BollhJon/ET20_Frackstock/IMG_20230823_181558.jpg

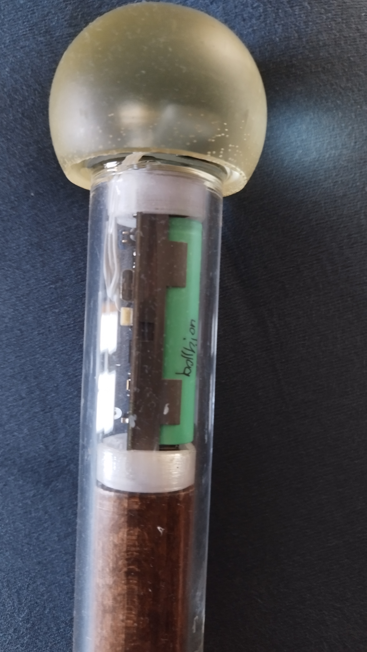
IMG_20230823_181558.jpg
