BollhJon/ET20_Frackstock/IMG_20230823_181706.jpg

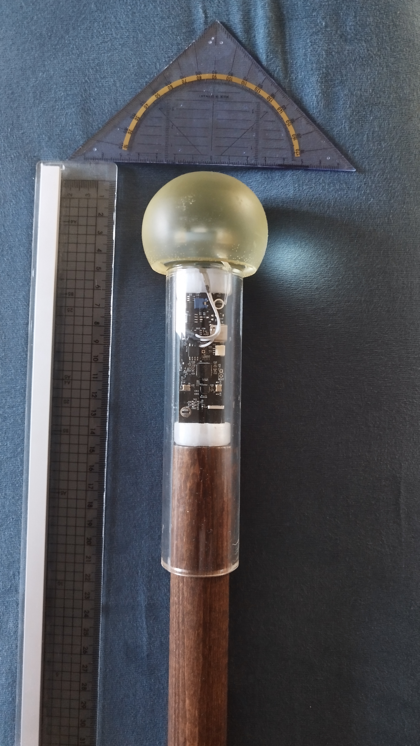
IMG_20230823_181706.jpg
