BollhJon/ET20_Frackstock/IMG_20230823_181511.jpg

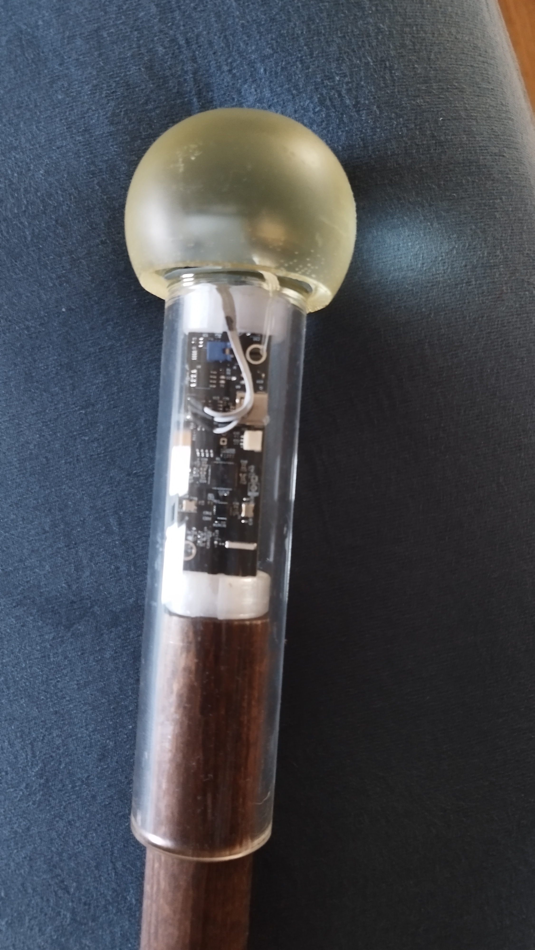
IMG_20230823_181511.jpg
