BollhJon/ET20_Frackstock/IMG_20230823_181516.jpg

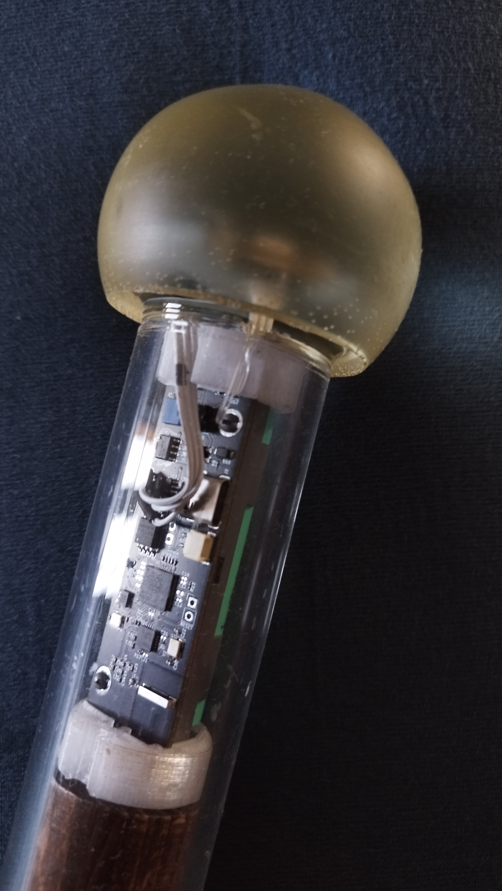
IMG_20230823_181516.jpg
