BollhJon/ET20_Frackstock/IMG_20230823_181718.jpg

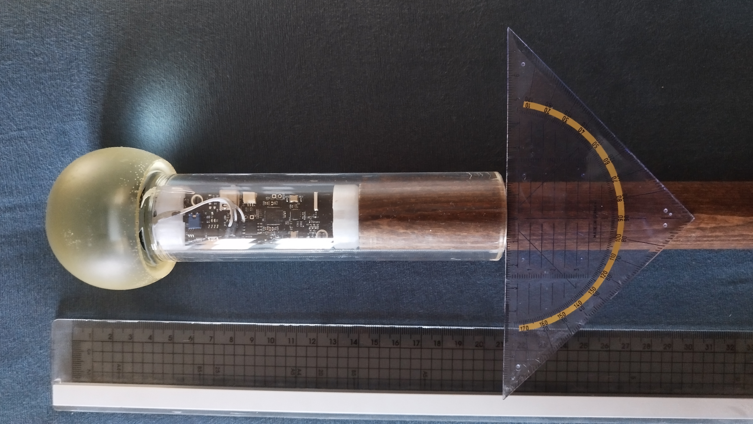
IMG_20230823_181718.jpg
