BollhJon/ET20_Frackstock/PCB_Frackstock/Frackstock.step

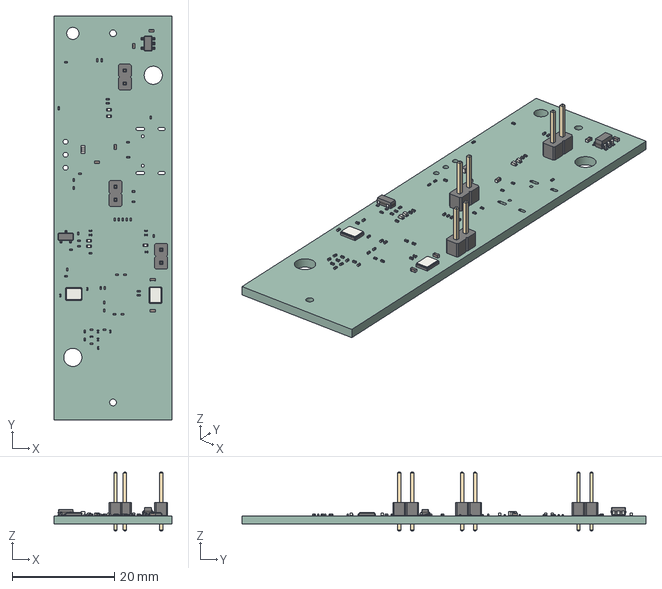
[picture p6: CAD file, 2023-08-23]
PCB_Frackstock/Frackstock.step
23.0 x 79.0 x 11.5 mm
Frackstock PCB
