BollhJon/ET20_Frackstock/PCB_Frackstock/Frackstock.kicad_pcb

## KiCad design PCB_Frackstock/Frackstock.kicad_pcb (2023-08-23)

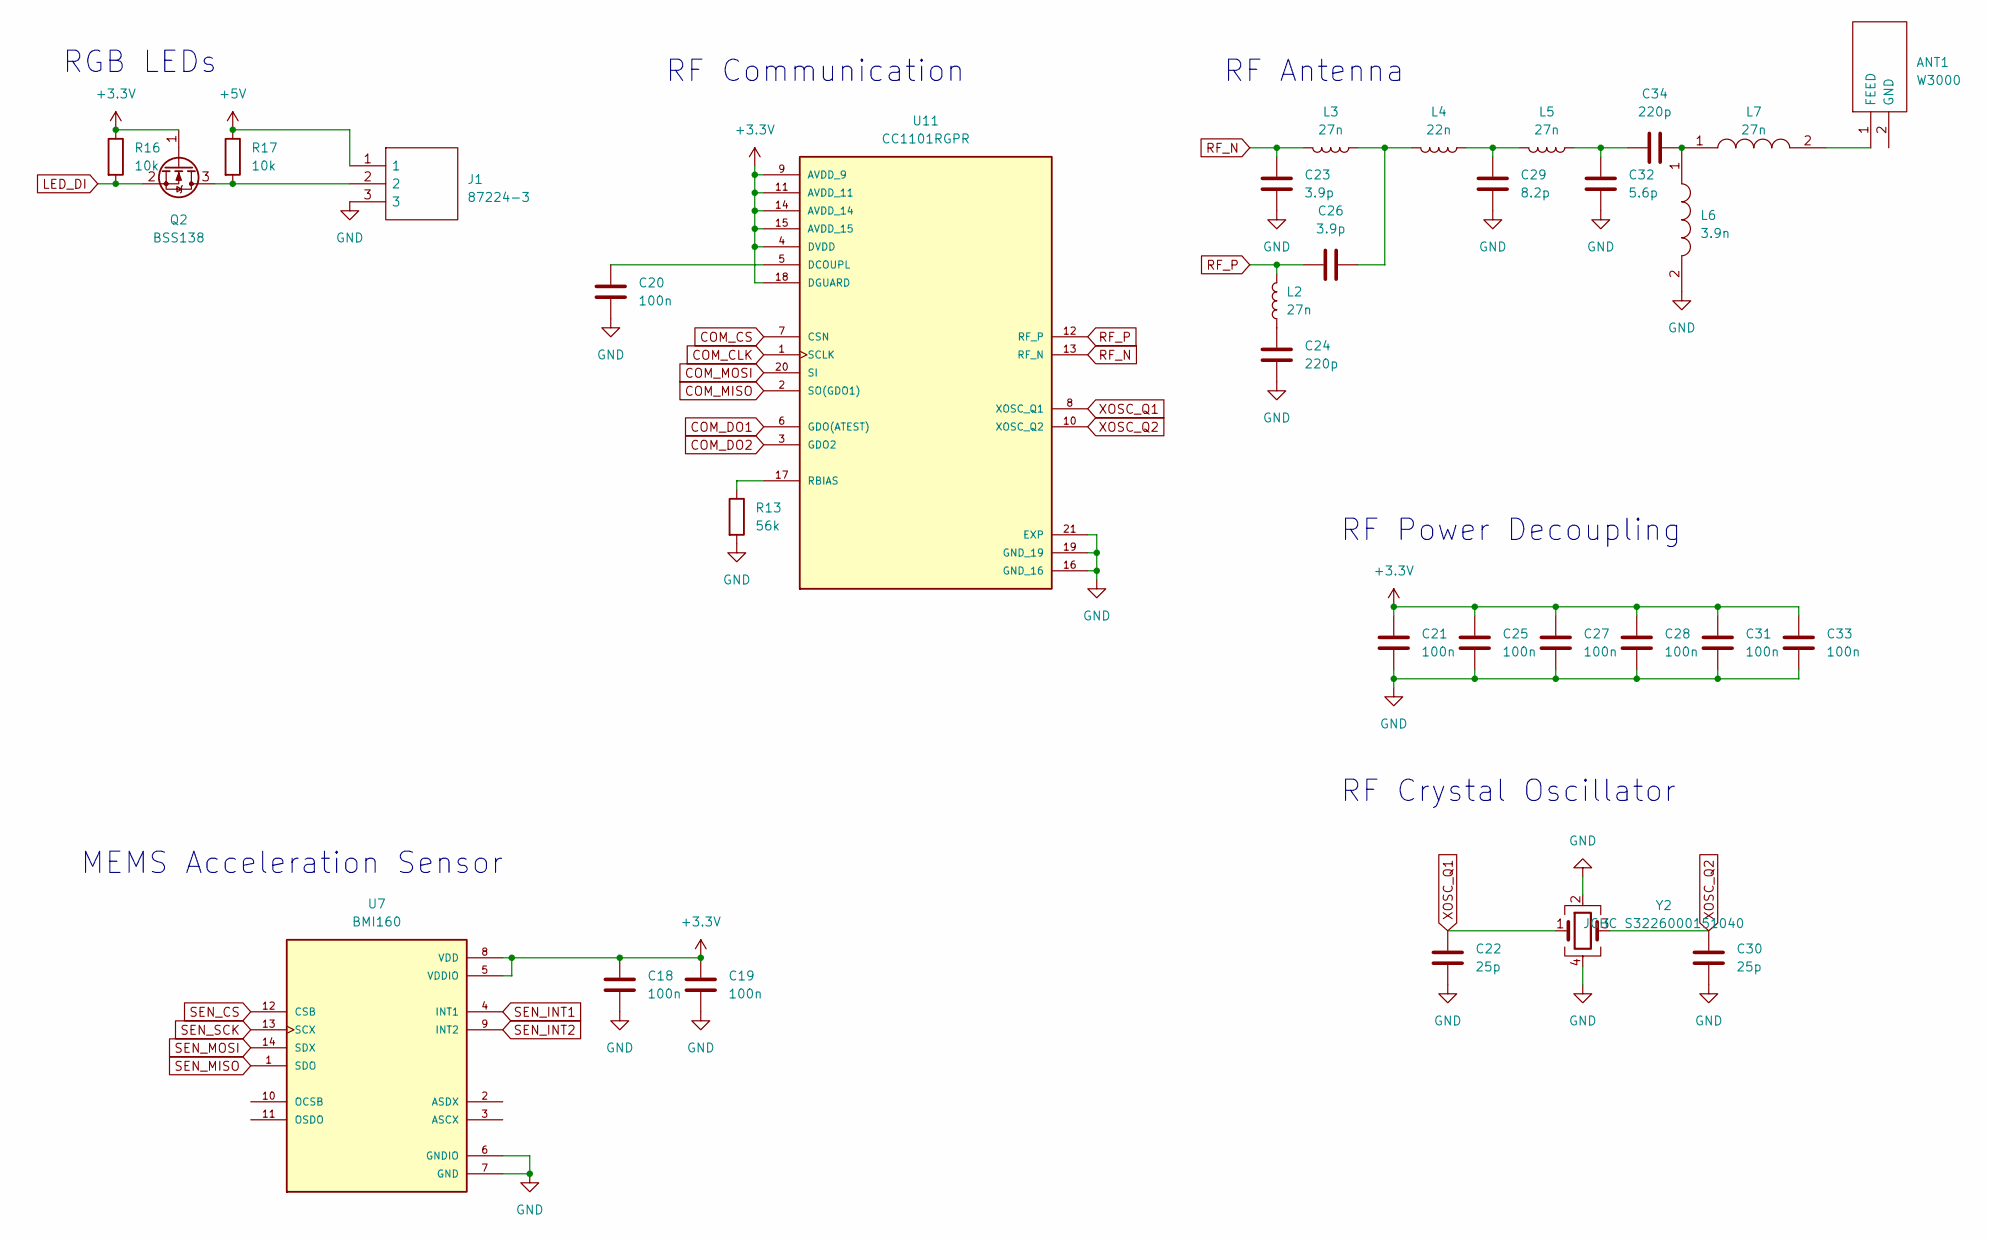
[picture p7: schematic InputOutput.kicad_sch]

Parts:
ANT1: W3000; Manufacturer_Part_Number W3000; Mouser Part Number 673-W3000
C18, C19, C20, C21, C25, C27, C28, C31, C33: 100n; C_0201_0603Metric; LCSC C66938
C22, C30: 25p; C_0402_1005Metric; LCSC C5186872
C23, C26: 3.9p; C_0201_0603Metric; LCSC C285000
C24, C34: 220p; C_0201_0603Metric; LCSC C258475
C29: 8.2p; C_0201_0603Metric; LCSC C469622
C32: 5.6p; C_0201_0603Metric; LCSC C285131
J1: 87224-3; 872243; Manufacturer_Part_Number 87224-3; Mouser Part Number 571-872243
L2, L3, L5: 27n; L_0201_0603Metric; LCSC C95928
L4: 22n; L_0201_0603Metric; LCSC C275177
L6: 3.9n; MHQ1005; Manufacturer_Part_Number MHQ1005P3N9CT000; Mouser Part Number 810-MHQ1005P3N9CT000
L7: 27n; MLG1005; Manufacturer_Part_Number MLG1005S27NHT000; Mouser Part Number 810-MLG1005S27NHT000
Q2: BSS138; SOT-23; LCSC C2938375
R13: 56k; R_0201_0603Metric; LCSC C851761
R16, R17: 10k; R_0201_0603Metric; LCSC C106225
U7: BMI160; PQFN50P250X300X88-14N; PARTREV 1.0; LCSC C94021
U11: CC1101RGPR; QFN50P400X400X100-21N; PARTREV 6-May-2020; LCSC C29953
Y2: JGHC S3226000151040; Crystal_SMD_3225-4Pin_3.2x2.5mm; LCSC C479205

Connections:
+3.3V: C18.1, C19.1, C21.1, C25.1, C27.1, C28.1, C31.1, C33.1, Q2.1 (G), R16.1, U7.5 (VDDIO), U7.8 (VDD), U11.4 (DVDD), U11.9 (AVDD_9), U11.11 (AVDD_11), U11.14 (AVDD_14), U11.15 (AVDD_15), U11.18 (DGUARD); also elsewhere on the board
+5V: J1.1, R17.1; also elsewhere on the board
COM_CLK: U11.1 (SCLK); also elsewhere on the board
COM_CS: U11.7 (CSN); also elsewhere on the board
COM_DO1: U11.6 (GDO(ATEST)); also elsewhere on the board
COM_DO2: U11.3 (GDO2); also elsewhere on the board
COM_MISO: U11.2 (SO(GDO1)); also elsewhere on the board
COM_MOSI: U11.20 (SI); also elsewhere on the board
GND: C18.2, C19.2, C20.2, C21.2, C22.2, C23.2, C24.2, C25.2, C27.2, C28.2, C29.2, C30.2, C31.2, C32.2, C33.2, J1.3, L6.2, R13.2, U7.6 (GNDIO), U7.7 (GND), U11.16 (GND_16), U11.19 (GND_19), U11.21 (EXP), Y2.2, Y2.4; also elsewhere on the board
LED_DI: Q2.2 (S), R16.2; also elsewhere on the board
unnamed: ANT1.1 (FEED), L7.2
unnamed: C24.1, L2.1
unnamed: C26.2, L3.1, L4.2
unnamed: C29.1, L4.1, L5.2
unnamed: C32.1, C34.1, L5.1
unnamed: C34.2, L6.1, L7.1
unnamed: J1.2, Q2.3 (D), R17.2
unnamed: C20.1, U11.5 (DCOUPL)
unnamed: R13.1, U11.17 (RBIAS)
RF_N: C23.1, L3.2, U11.13 (RF_N)
RF_P: C26.1, L2.2, U11.12 (RF_P)
SEN_CS: U7.12 (CSB); also elsewhere on the board
SEN_INT1: U7.4 (INT1); also elsewhere on the board
SEN_INT2: U7.9 (INT2); also elsewhere on the board
SEN_MISO: U7.1 (SDO); also elsewhere on the board
SEN_MOSI: U7.14 (SDX); also elsewhere on the board
SEN_SCK: U7.13 (SCX); also elsewhere on the board
XOSC_Q1: C22.1, U11.8 (XOSC_Q1), Y2.1
XOSC_Q2: C30.1, U11.10 (XOSC_Q2), Y2.3

Notes on the sheet:
MEMS Acceleration Sensor
RF Power Decoupling
RF Communication
RF Crystal Oscillator
RF Antenna
RGB LEDs

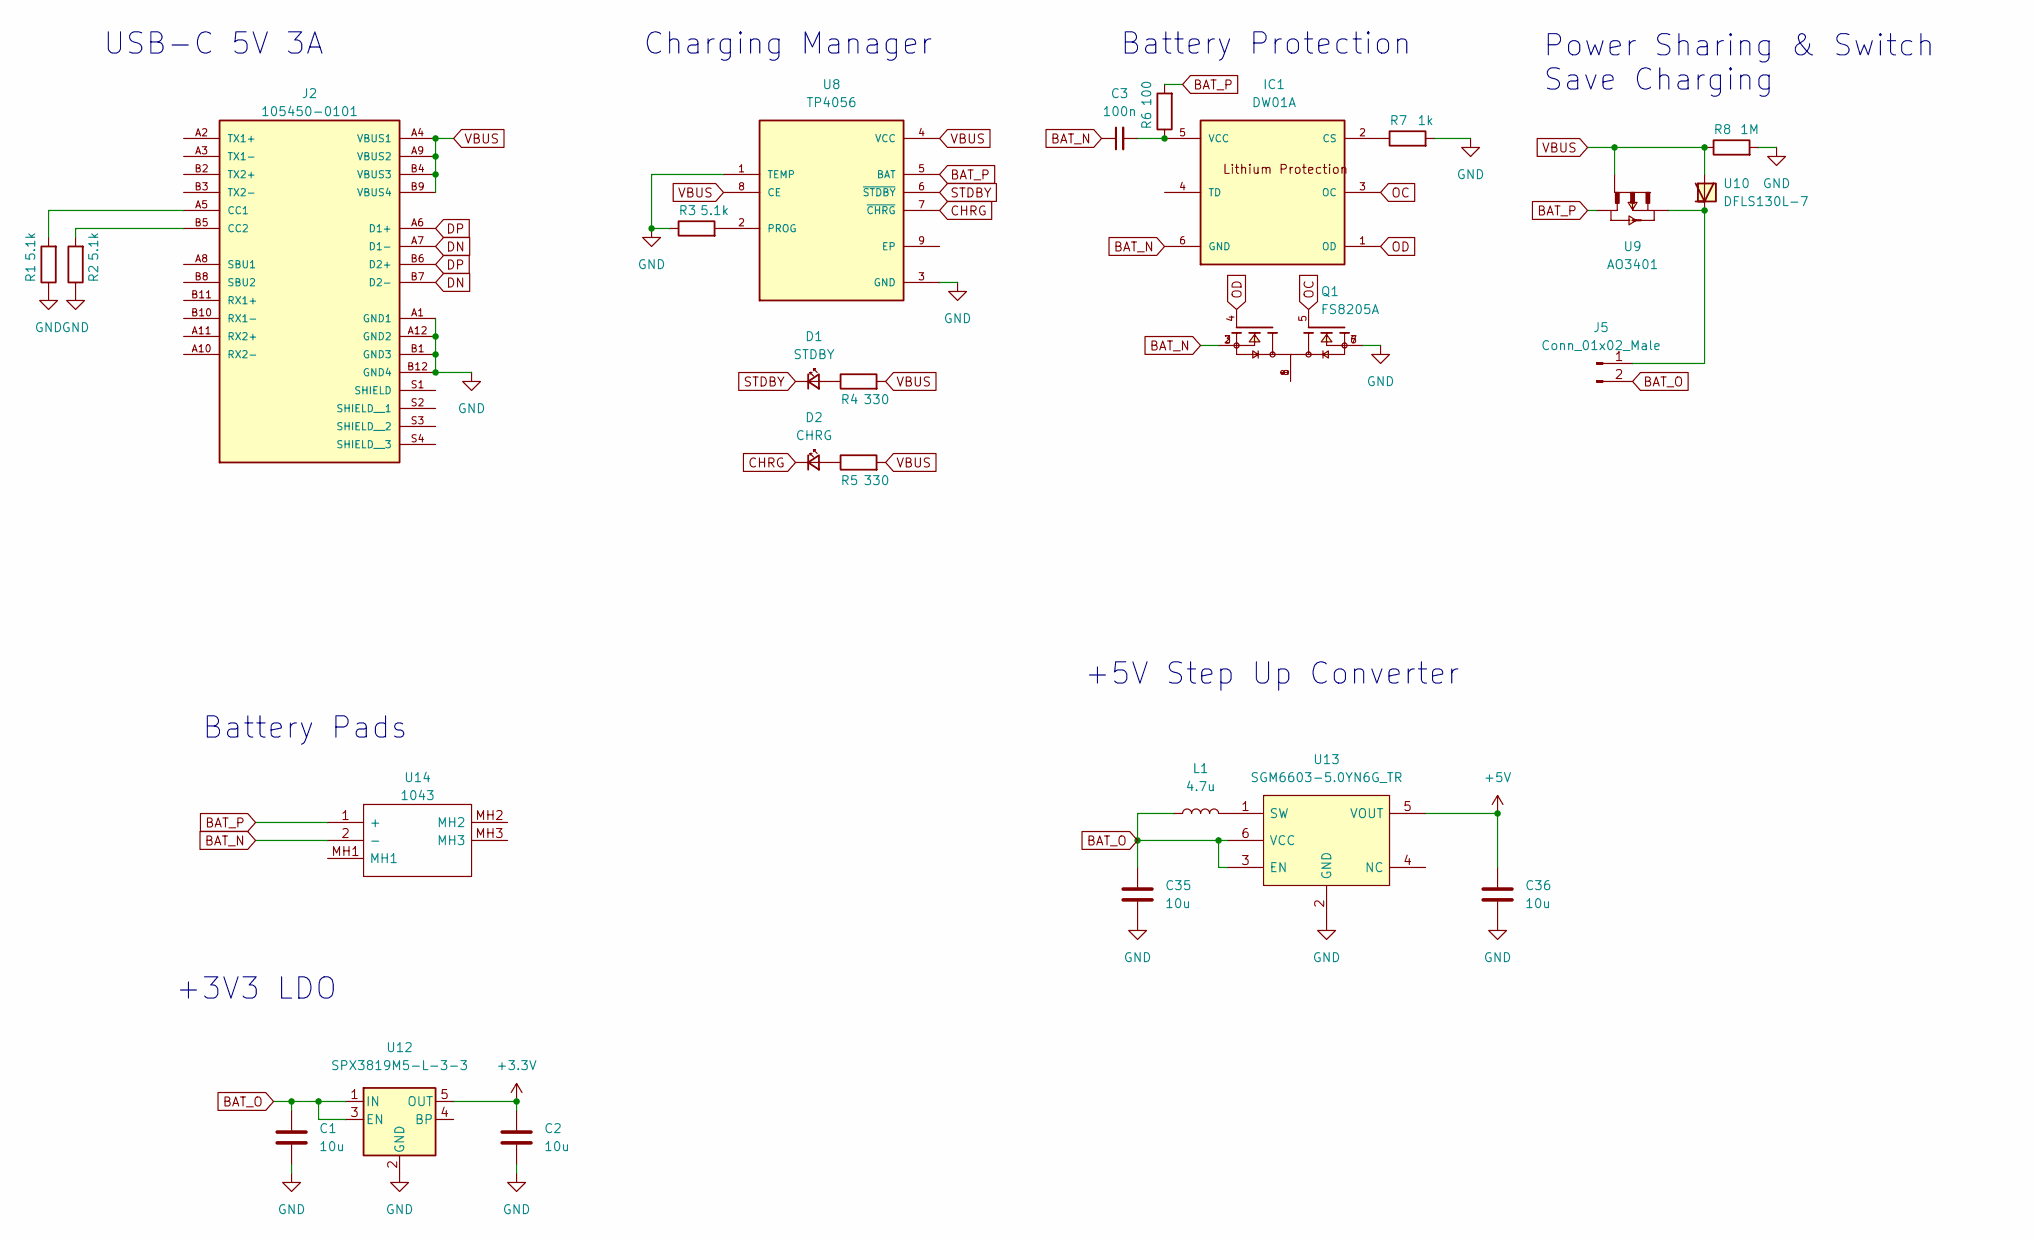
[picture p8: schematic PowerSupply.kicad_sch]

Parts:
C1, C2, C35, C36: 10u; C_0402_1005Metric; LCSC C15525
C3: 100n; C_0201_0603Metric; LCSC C66938
D1: STDBY; LED_0402_1005Metric; LCSC C434446
D2: CHRG; LED_0402_1005Metric; LCSC C434445
IC1: DW01A; SOT23-6; MPN DW01A; LCSC C351410
J2: 105450-0101; MOLEX_105450-0101; LCSC C134092
J5: Conn_01x02_Male; PinHeader_1x02_P2.54mm_Vertical
L1: 4.7u; L_0603_1608Metric; LCSC C1034
Q1: FS8205A; SOP65P640X120-8N; PARTREV 1.7; LCSC C16052
R1, R2, R3: 5.1k; R_0201_0603Metric; LCSC C274341
R4, R5: 330; R_0201_0603Metric; LCSC C851717
R6: 100; R_0201_0603Metric; LCSC C77623
R7: 1k; R_0201_0603Metric; LCSC C138165
R8: 1M; R_0201_0603Metric; LCSC C473482
U8: TP4056; SOP127P600X175-9N; LCSC C725790
U9: AO3401; SOT23; LCSC C727156
U10: DFLS130L-7; POWERDI123; LCSC C110493
U12: SPX3819M5-L-3-3; SOT-23-5; LCSC C9055
U13: SGM6603-5.0YN6G_TR; SOT23-6; Manufacturer_Part_Number SGM6603-5.0YN6G/TR; LCSC C79689
U14: 1043; Manufacturer_Part_Number 1043; Mouser Part Number 534-1043

Connections:
+3.3V: C2.1, U12.5 (OUT); also elsewhere on the board
+5V: C36.1, U13.5 (VOUT); also elsewhere on the board
BAT_N: C3.1, IC1.6 (GND), Q1.2, Q1.3, U14.2 (-)
BAT_O: C1.1, C35.1, J5.2, L1.1, U12.1 (IN), U12.3 (EN), U13.3 (EN), U13.6 (VCC)
BAT_P: R6.2, U8.5 (BAT), U9.3, U14.1 (+)
CHRG: D2.1 (K), U8.7 (~CHRG)
DN: J2.A7 (D1-), J2.B7 (D2-); also elsewhere on the board
DP: J2.A6 (D1+), J2.B6 (D2+); also elsewhere on the board
GND: C1.2, C2.2, C35.2, C36.2, J2.A1 (GND1), J2.A12 (GND2), J2.B1 (GND3), J2.B12 (GND4), Q1.6, Q1.7, R1.1, R2.1, R3.1, R7.2, R8.2, U8.1 (TEMP), U8.3 (GND), U12.2 (GND), U13.2 (GND); also elsewhere on the board
unnamed: D1.2 (A), R4.1
unnamed: D2.2 (A), R5.1
unnamed: IC1.2 (CS), R7.1
unnamed: C3.2, IC1.5 (VCC), R6.1
unnamed: J2.A5 (CC1), R1.2
unnamed: J2.B5 (CC2), R2.2
unnamed: J5.1, U9.2, U10.P$1
unnamed: Q1.1, Q1.8
unnamed: R3.2, U8.2 (PROG)
unnamed: L1.2, U13.1 (SW)
OC: IC1.3 (OC), Q1.5
OD: IC1.1 (OD), Q1.4
STDBY: D1.1 (K), U8.6 (~STDBY)
VBUS: J2.A4 (VBUS1), J2.A9 (VBUS2), J2.B4 (VBUS3), J2.B9 (VBUS4), R4.2, R5.2, R8.1, U8.4 (VCC), U8.8 (CE), U9.1, U10.P$2

Notes on the sheet:
Power Sharing & Switch Save Charging
+5V Step Up Converter
Battery Pads
+3V3 LDO
Battery Protection
Charging Manager
USB-C 5V 3A

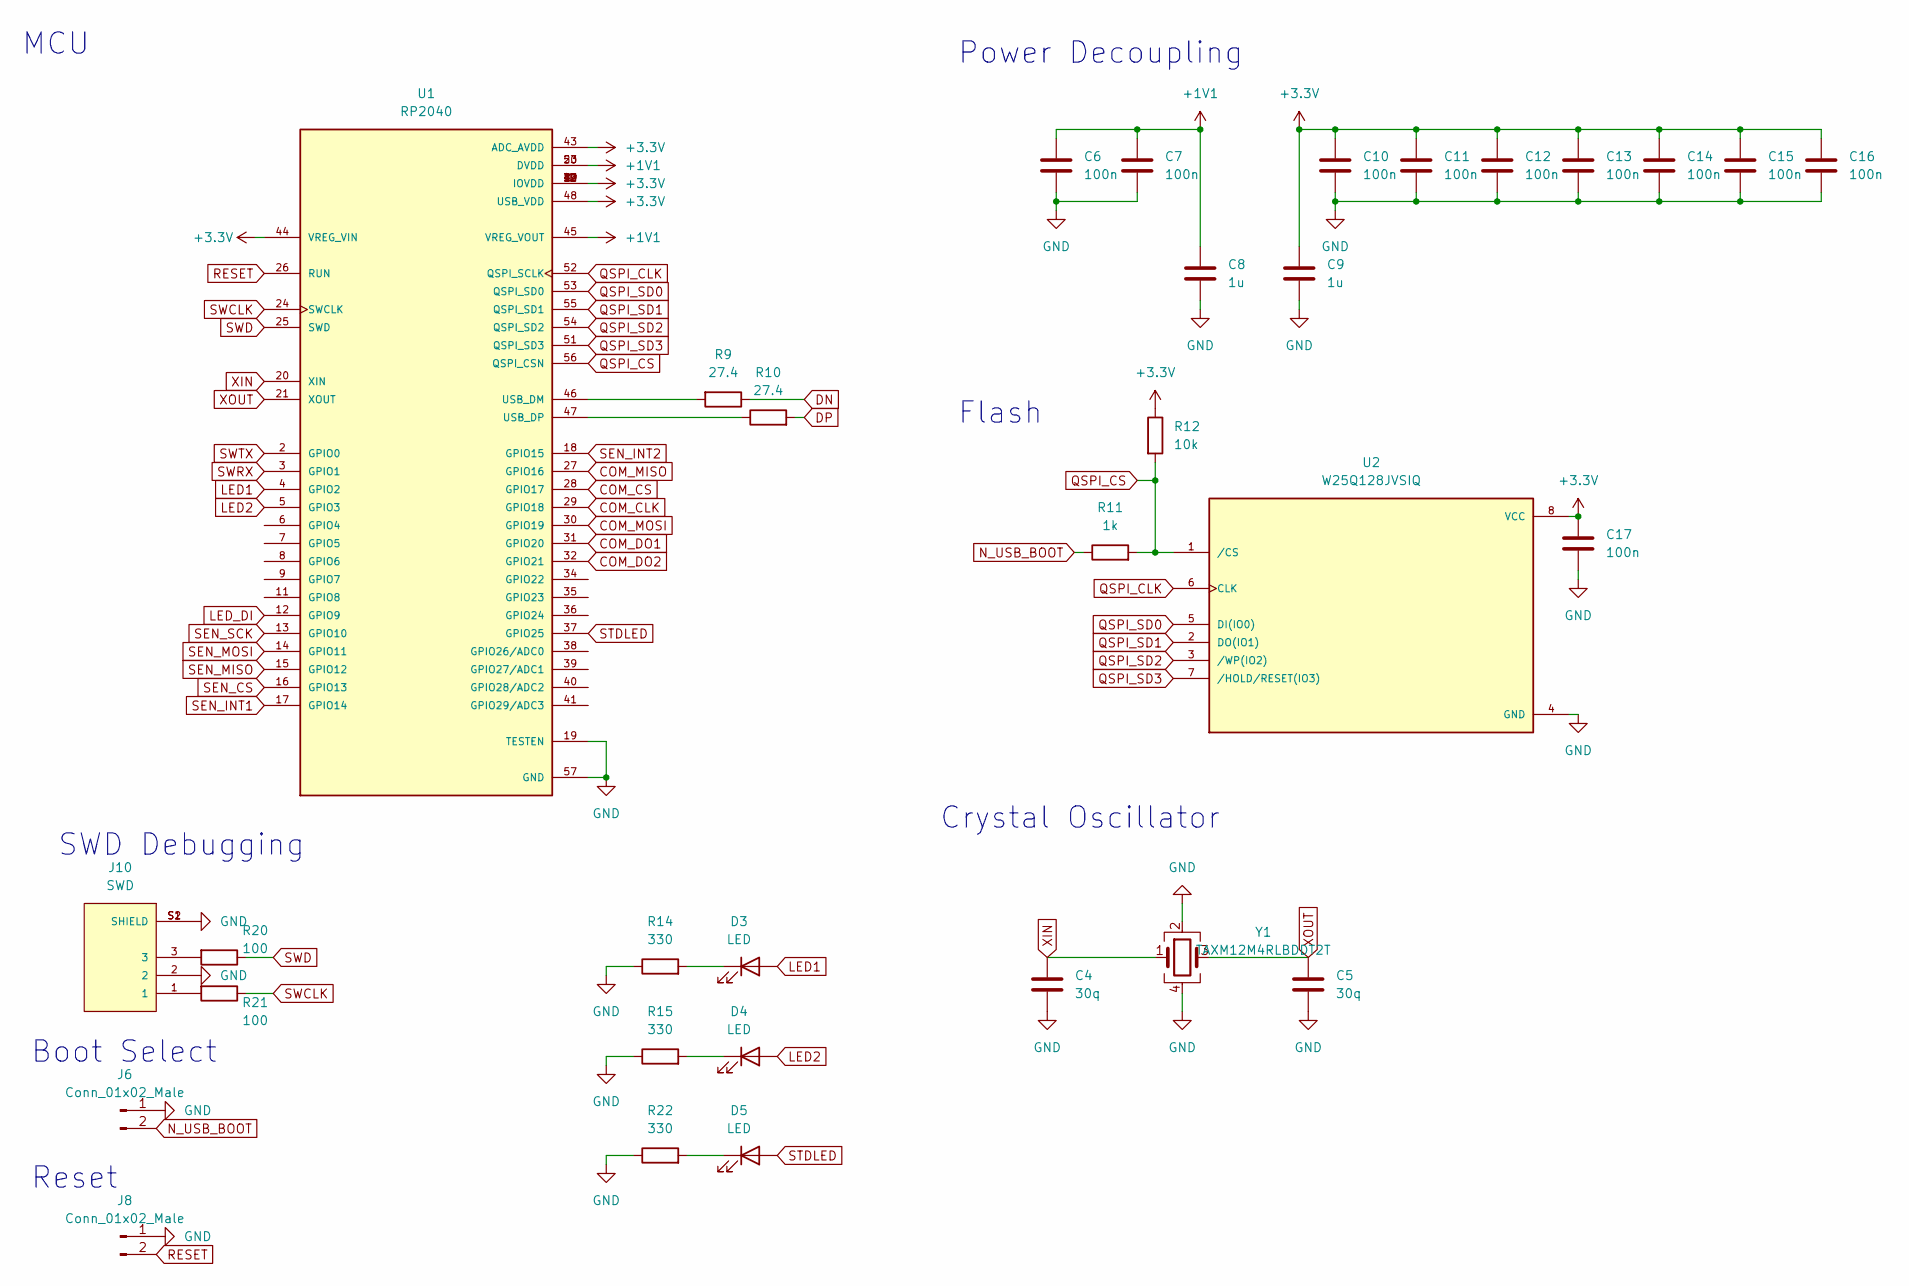
[picture p9: schematic MCUrp2040.kicad_sch]

Parts:
C4, C5: 30q; C_0201_0603Metric; LCSC C312064
C6, C7, C10, C11, C12, C13, C14, C15, C16, C17: 100n; C_0201_0603Metric; LCSC C66938
C8, C9: 1u; C_0201_0603Metric; LCSC C87143
D3, D4, D5: LED; LED_0402_1005Metric; LCSC C434447
J6, J8: Conn_01x02_Male; PinHeader_1x02_P2.54mm_Vertical
J10: SWD; JST_SM03B-SRSS-TB(LF)(SN); LCSC C160403
R9, R10: 27.4; R_0201_0603Metric; LCSC C423620
R11: 1k; R_0201_0603Metric; LCSC C138165
R12: 10k; R_0201_0603Metric; LCSC C106225
R14, R15, R22: 330; R_0201_0603Metric; LCSC C851717
R20, R21: 100; R_0201_0603Metric; LCSC C77623
U1: RP2040; QFN40P700X700X90-57N; PARTREV 1.6.1; LCSC C2040
U2: W25Q128JVSIQ; SOIC127P790X216-8N; PARTREV I; LCSC C113767
Y1: TAXM12M4RLBDDT2T; Crystal_SMD_3225-4Pin_3.2x2.5mm; LCSC C133334

Connections:
+1V1: C6.1, C7.1, C8.1, U1.23 (DVDD), U1.45 (VREG_VOUT), U1.50 (DVDD)
+3.3V: C9.1, C10.1, C11.1, C12.1, C13.1, C14.1, C15.1, C16.1, C17.1, R12.1, U1.1 (IOVDD), U1.10 (IOVDD), U1.22 (IOVDD), U1.33 (IOVDD), U1.42 (IOVDD), U1.43 (ADC_AVDD), U1.44 (VREG_VIN), U1.48 (USB_VDD), U1.49 (IOVDD), U2.8 (VCC); also elsewhere on the board
COM_CLK: U1.29 (GPIO18); also elsewhere on the board
COM_CS: U1.28 (GPIO17); also elsewhere on the board
COM_DO1: U1.31 (GPIO20); also elsewhere on the board
COM_DO2: U1.32 (GPIO21); also elsewhere on the board
COM_MISO: U1.27 (GPIO16); also elsewhere on the board
COM_MOSI: U1.30 (GPIO19); also elsewhere on the board
DN: R9.1; also elsewhere on the board
DP: R10.2; also elsewhere on the board
GND: C4.2, C5.2, C6.2, C7.2, C8.2, C9.2, C10.2, C11.2, C12.2, C13.2, C14.2, C15.2, C16.2, C17.2, J6.1, J8.1, J10.2, J10.S1 (SHIELD), J10.S2 (SHIELD), R14.1, R15.1, R22.1, U1.19 (TESTEN), U1.57 (GND), U2.4 (GND), Y1.2, Y1.4; also elsewhere on the board
LED1: D3.2 (A), U1.4 (GPIO2)
LED2: D4.2 (A), U1.5 (GPIO3)
LED_DI: U1.12 (GPIO9); also elsewhere on the board
N_USB_BOOT: J6.2, R11.1
unnamed: D3.1 (K), R14.2
unnamed: D4.1 (K), R15.2
unnamed: D5.1 (K), R22.2
unnamed: J10.1, R21.2
unnamed: J10.3, R20.2
unnamed: R9.2, U1.46 (USB_DM)
unnamed: R10.1, U1.47 (USB_DP)
QSPI_CLK: U1.52 (QSPI_SCLK), U2.6 (CLK)
QSPI_CS: R11.2, R12.2, U1.56 (QSPI_CSN), U2.1 (/CS)
QSPI_SD0: U1.53 (QSPI_SD0), U2.5 (DI(IO0))
QSPI_SD1: U1.55 (QSPI_SD1), U2.2 (DO(IO1))
QSPI_SD2: U1.54 (QSPI_SD2), U2.3 (/WP(IO2))
QSPI_SD3: U1.51 (QSPI_SD3), U2.7 (/HOLD/RESET(IO3))
RESET: J8.2, U1.26 (RUN)
SEN_CS: U1.16 (GPIO13); also elsewhere on the board
SEN_INT1: U1.17 (GPIO14); also elsewhere on the board
SEN_INT2: U1.18 (GPIO15); also elsewhere on the board
SEN_MISO: U1.15 (GPIO12); also elsewhere on the board
SEN_MOSI: U1.14 (GPIO11); also elsewhere on the board
SEN_SCK: U1.13 (GPIO10); also elsewhere on the board
STDLED: D5.2 (A), U1.37 (GPIO25)
SWCLK: R21.1, U1.24 (SWCLK)
SWD: R20.1, U1.25 (SWD)
SWRX: U1.3 (GPIO1)
SWTX: U1.2 (GPIO0)
XIN: C4.1, U1.20 (XIN), Y1.1
XOUT: C5.1, U1.21 (XOUT), Y1.3

Notes on the sheet:
MCU
Reset
Flash
Power Decoupling
Crystal Oscillator
SWD Debugging
Boot Select

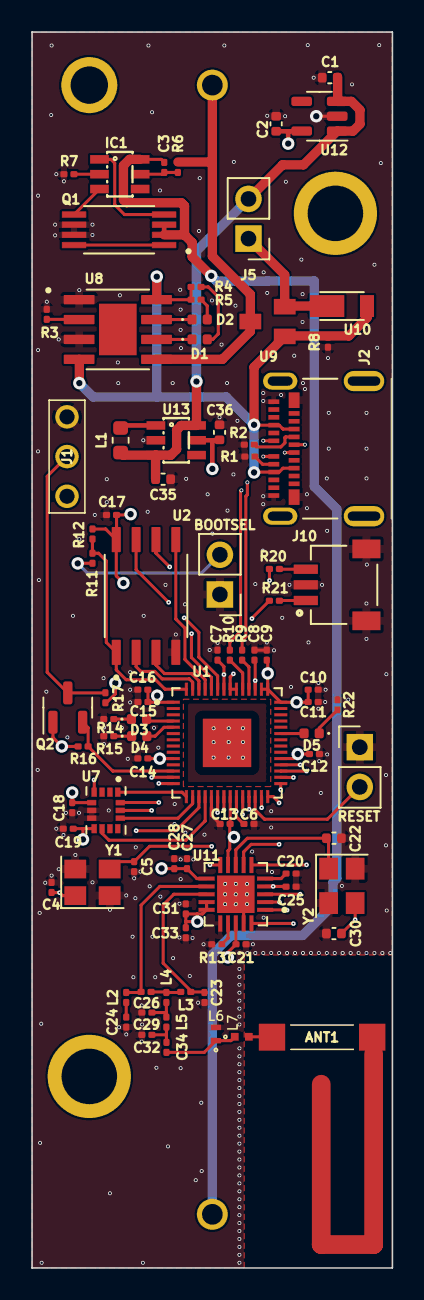
[picture p10: board Frackstock.kicad_pcb from above]

Board: 4 copper layers, 23.0 x 79.0 mm, 90 parts (1 on the bottom side), 72 nets.
